Decclo/EcoDome---Intelligent-Greenhouse-Control-System/Final Report/EcoDome - Intelligent Greenhouse Control System - Appendix B.pdf

1

Appendix B - Schematics

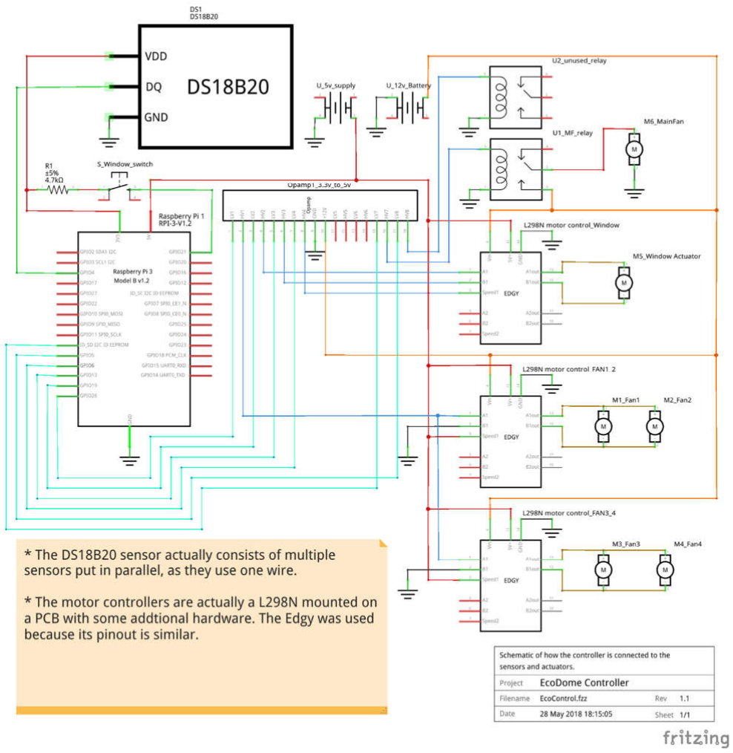
[picture p18: figure]

Figure 1 Schematics of the EcoDome hardware
