Decclo/EcoDome---Intelligent-Greenhouse-Control-System/Schematics/EcoDome_ControlBox_Schematic.pdf

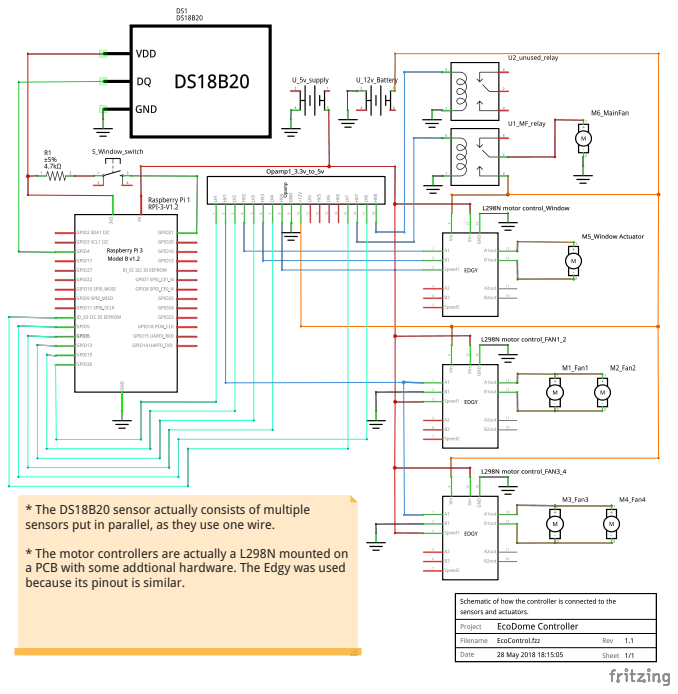
[picture p19: page 1]

* The DS18B20 sensor actually consists of multiple
sensors put in parallel, as they use one wire.

* The motor controllers are actually a L298N mounted on
a PCB with some addtional hardware. The Edgy was used
because its pinout is similar.
