Decclo/EcoDome---Intelligent-Greenhouse-Control-System/(list of files, drawings)

Other design files:
Schematics/EcoControl.fzz
