Decclo/EcoDome---Intelligent-Greenhouse-Control-System/EcoDome_Software/DataDown.py

# Made by Hans V. Rasmussen for EcoDome Bachelor Project.
# Heavily inspired by https://www.summet.com/dmsi/html/readingTheWeb.html
# Version:          1.1
# Creation Date:    19/02/2018 14:30
# Last Edit:        18/05/2018 19:30

import urllib.request
from re import findall
import os, errno
import argparse


# Prepare the arguments:
parser = argparse.ArgumentParser(description='Downloads weather prognosis from yr.no, note that the webpage reffered to must be the .xml')

parser.add_argument('-dn', default='./data/wdata', help='Name as which the data should be saved, should be a path')
parser.add_argument('-wl', default='https://www.yr.no/place/Denmark/South_Denmark/S%C3%B8nderborg/forecast.xml', help='Address of the webpage to download data from')

args = parser.parse_args()

# Split the path and file name
pathtmp = args.dn.split("/")
path = ''

for i in range(len(pathtmp)-1):
    path = (path + pathtmp[i] + '/')

datName = pathtmp[len(pathtmp)-1]


## NOTES:
# Note about numbers: 
#   '\d*[.]?\d*' accepts numbers such as '1' , '7' , '2.7' , '300.7933'
#   The '.' can be exchanged for a ',' or both can be used at the same time.

# print (validFrom[0])  # Describes how to read from variables
# windDir_compact = findall(r'\d+[.]?\d*', windDir[0])  # how to extract actual value from saved data


## Read the webpage:
# https://www.yr.no/place/Denmark/South_Denmark/S%C3%B8nderborg/forecast.xml
response = urllib.request.urlopen(args.wl)
html = response.read()
text = html.decode()


## Find the data chunk we want
validFrom = findall(r'Valid at \d*-\d*-\d*T\d*:\d*:\d*', text)
#print (validFrom)

windDir = findall(r'windDirection deg="\d*[.]?\d*"', text)
#print (windDir)

windSpeed = findall(r'windSpeed mps="\d*[.]?\d*"', text)
#print (windSpeed)

temperature = findall(r'temperature unit="celsius" value="\d*[.]?[-]?\d*"', text)
#print (temperature)

pressure = findall(r'pressure unit="hPa" value="\d*[.]?\d*"', text)
#print (pressure)


## Make sure that the path for the weatherdata exists:
if not os.path.exists(path):
    os.makedirs(path)


## Print the data to files:
for i in range(len(validFrom)):
    
    # Debugging and awesomeness
    print("\n")
    print(validFrom[i])
    print(windDir[i])
    print(windSpeed[i])
    print(temperature[i])
    print(pressure[i])

    # open file and prepare to write:
    filestring = path + datName + str(i)
    file = open(filestring, "w")

    # prepare data to be written:
    validFrom_tmp = findall(r'\d*-\d*-\d*T\d*:\d*:\d*', validFrom[i])
    windDir_tmp = findall(r'\d+[.]?\d*', windDir[i])
    windSpeed_tmp = findall(r'\d+[.]?\d*', windSpeed[i])
    temperature_tmp = findall(r'\d+[.]?\d*', temperature[i])
    pressure_tmp = findall(r'\d+[.]?\d*', pressure[i])

    # write data:
    file.write(validFrom_tmp[0] + "\n")
    file.write(windDir_tmp[0] + "\n")
    file.write(windSpeed_tmp[0] + "\n")
    file.write(temperature_tmp[0] + "\n")
    file.write(pressure_tmp[0] + "\n")

    # close file and prepare for next iteration
    file.close()
